Thefec/eyes-keychain/case/kablo_yerlesim.png

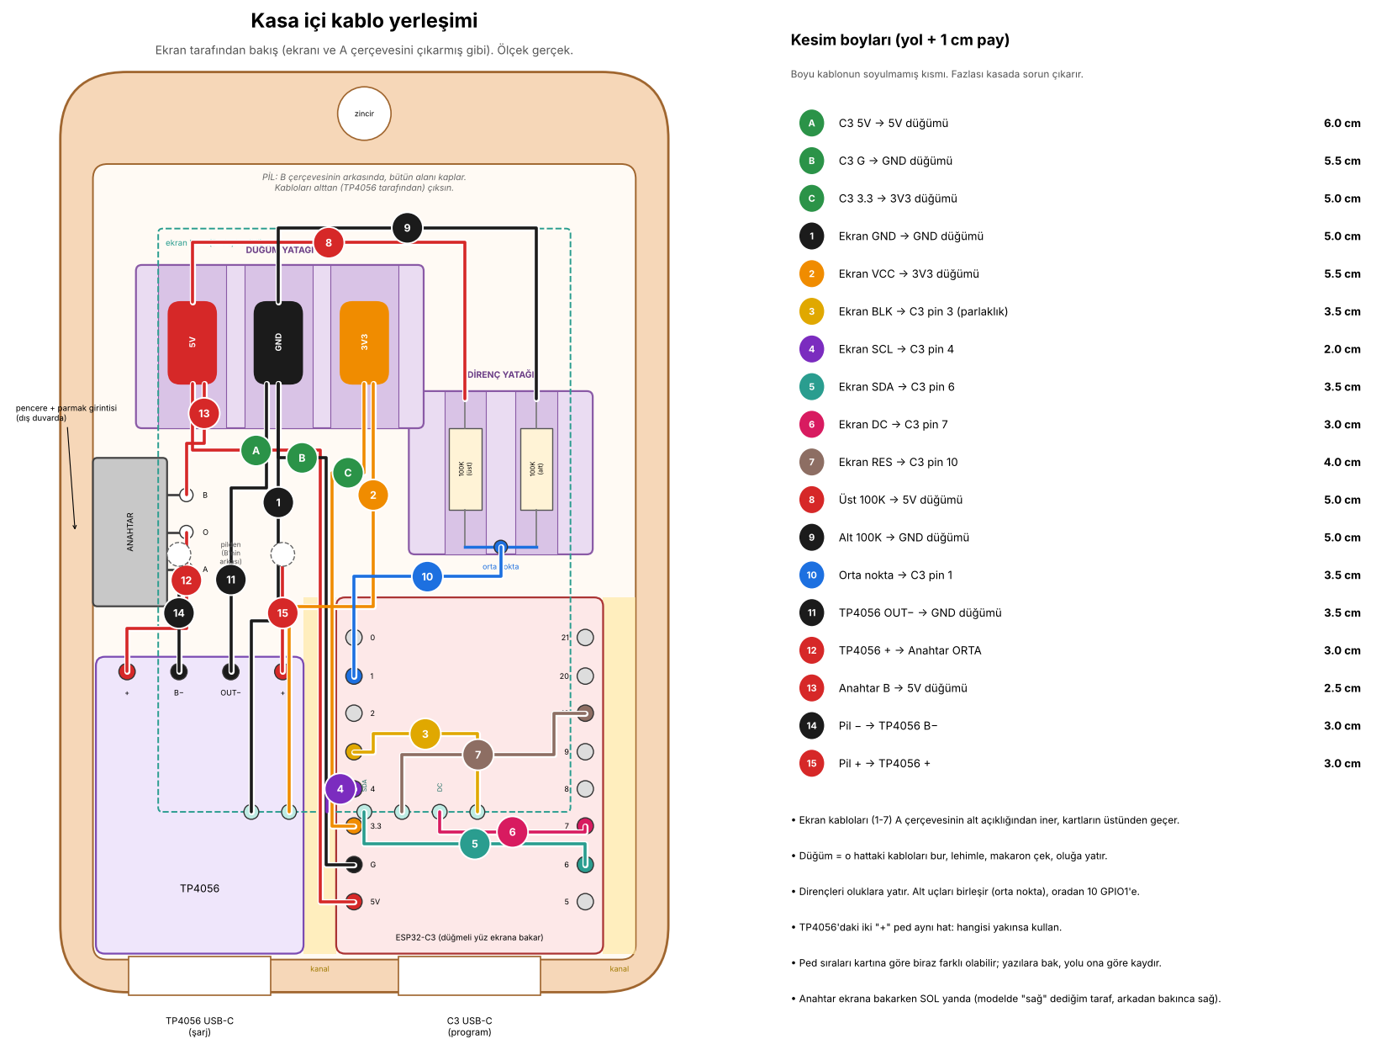
case/kablo_yerlesim.png
