Thefec/eyes-keychain/case/front.stl

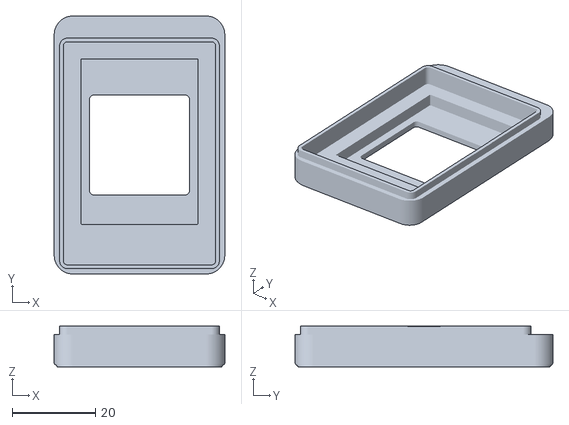
[picture p5: CAD file, 2026-11-05]
case/front.stl
41.0 x 62.0 x 9.75
