Thefec/eyes-keychain/case/ayirici_B.stl

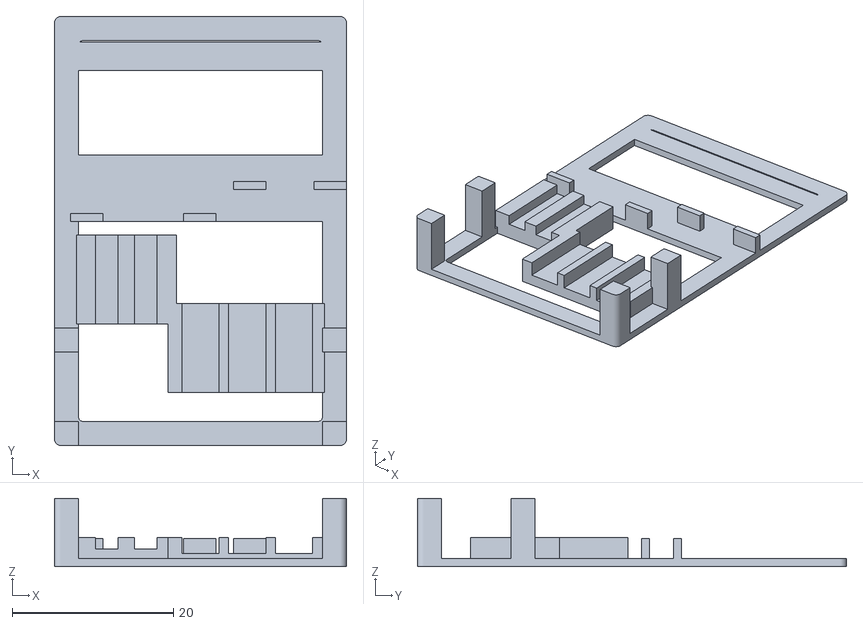
[picture p6: CAD file, 2026-11-05]
case/ayirici_B.stl
36.2 x 53.2 x 8.45
