Thefec/eyes-keychain/case/ayirici_A.stl

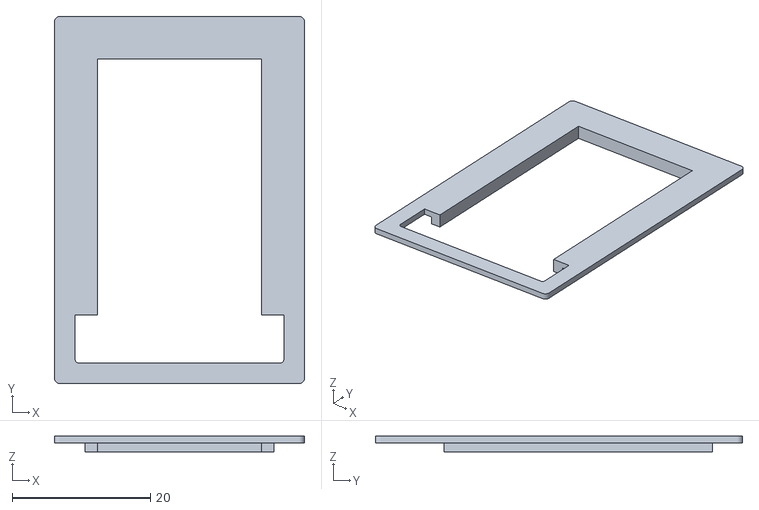
[picture p7: CAD file, 2026-11-05]
case/ayirici_A.stl
36.2 x 53.2 x 2.30
