Thefec/eyes-keychain/case/back.stl

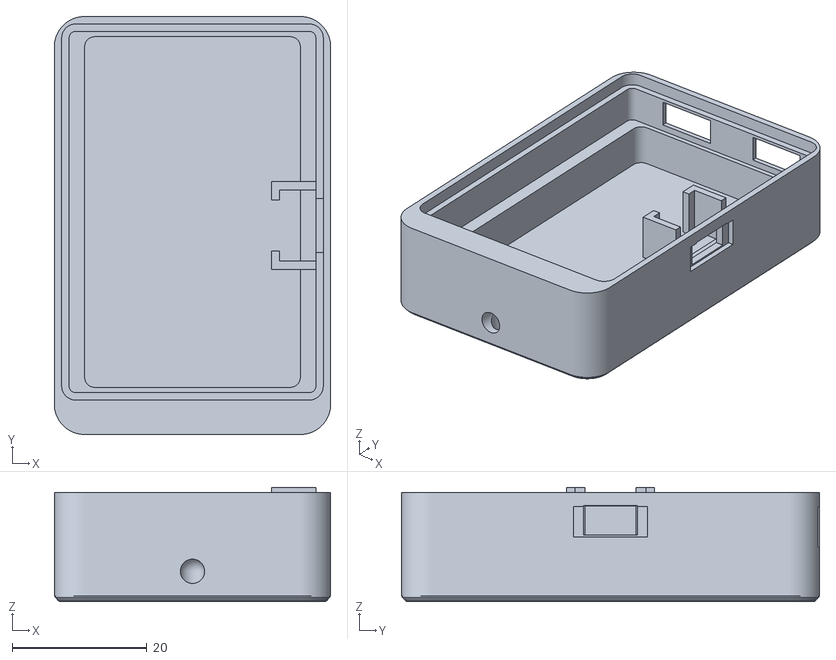
[picture p8: CAD file, 2026-11-05]
case/back.stl
41.0 x 62.0 x 17.0
