Thefec/eyes-keychain/(commit log)

2026-11-05 Add eyes keychain firmware, Android app, case and simulation
    Claude-Session: https://claude.ai/code/session_01AToPhb2g3YuCZnQ4HLnpCL
    [ayirici_A.stl, ayirici_B.stl, back.stl, front.stl]
2026-11-05 README: use solder diagram v3 instead of wiring layout
    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
